GabiBrawl/Utsuwa/assets/Shopping Cart Screenshots/ALIEXPRESS.png

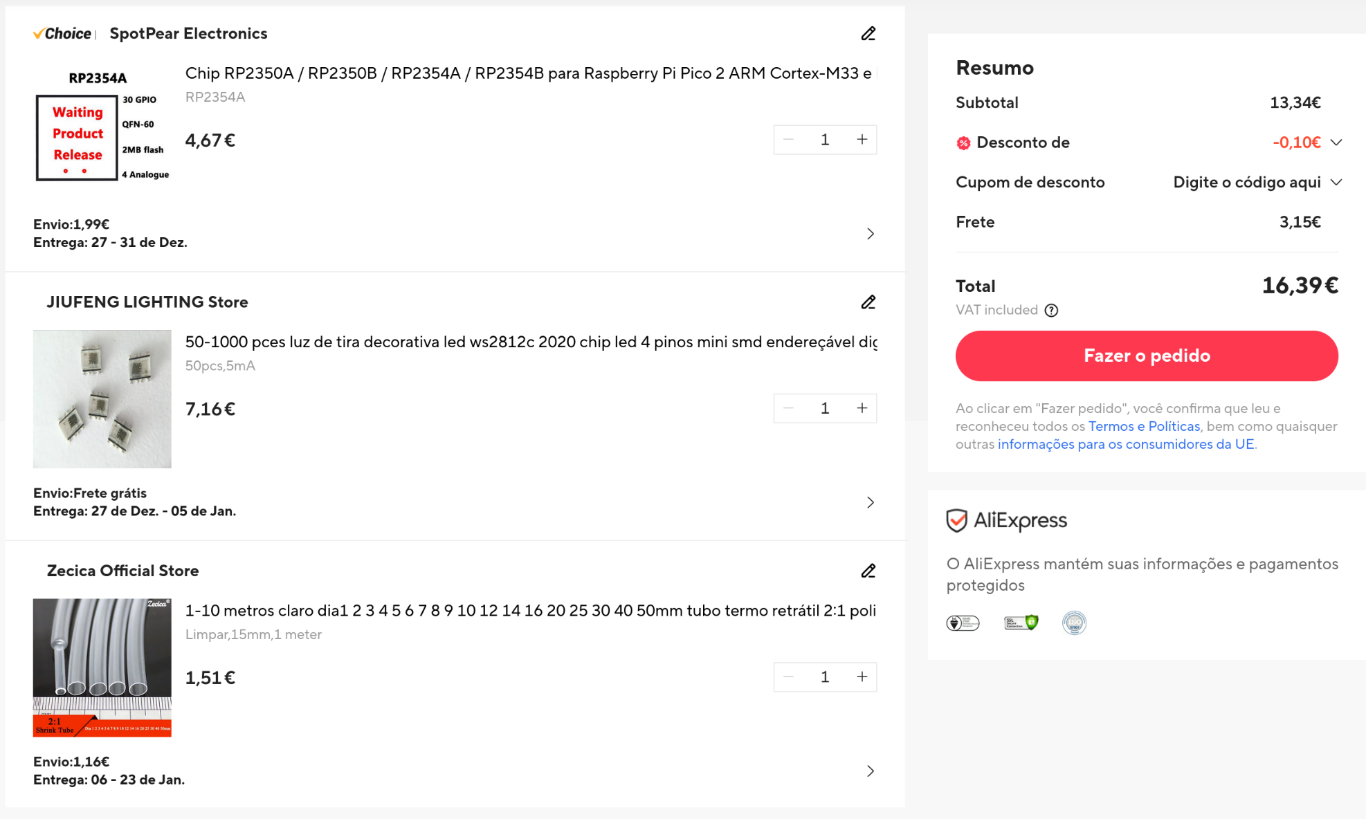
assets/Shopping Cart Screenshots/ALIEXPRESS.png
