GabiBrawl/Utsuwa/assets/Shopping Cart Screenshots/ALIEXPRESS_SHRINKING_TUBES.png

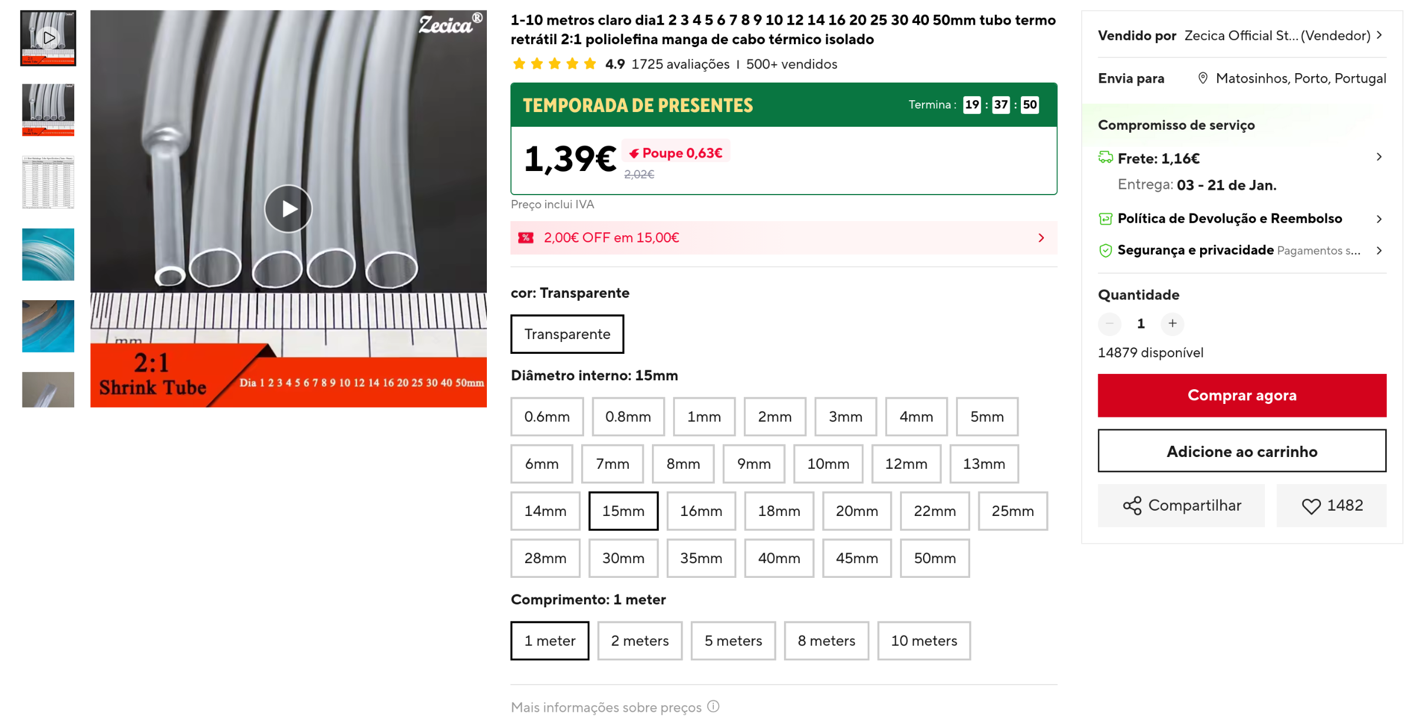
assets/Shopping Cart Screenshots/ALIEXPRESS_SHRINKING_TUBES.png
