GabiBrawl/Utsuwa/assets/Shopping Cart Screenshots/DIGIKEY1.png

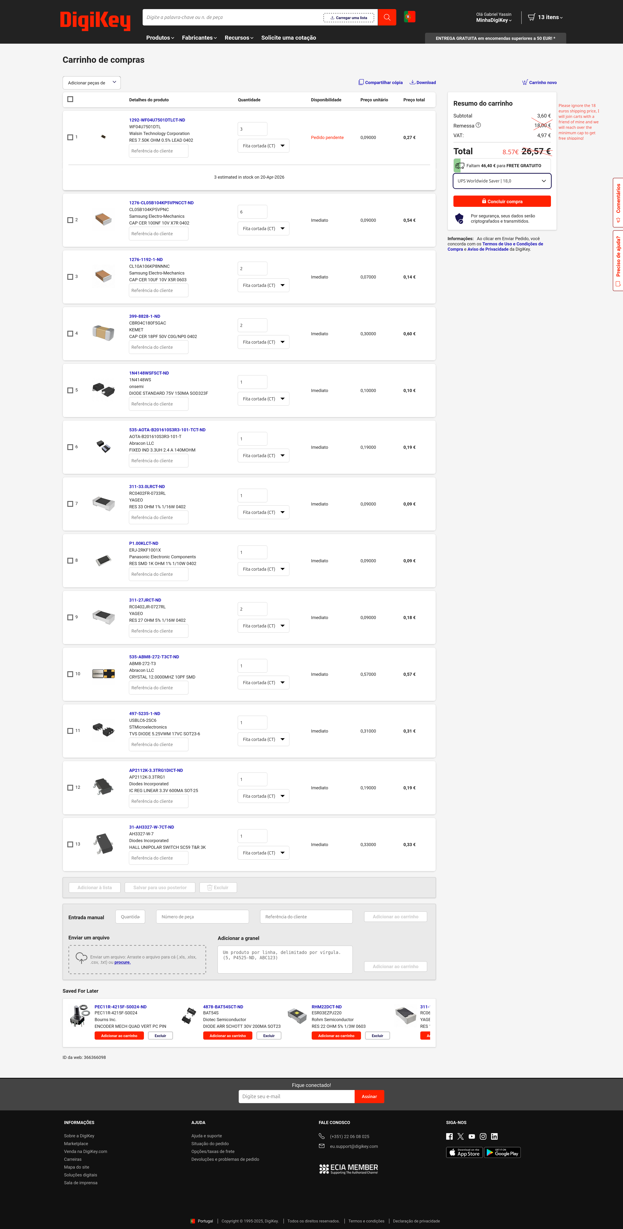
assets/Shopping Cart Screenshots/DIGIKEY1.png
