GabiBrawl/Utsuwa/assets/Shopping Cart Screenshots/JLCPCB.png

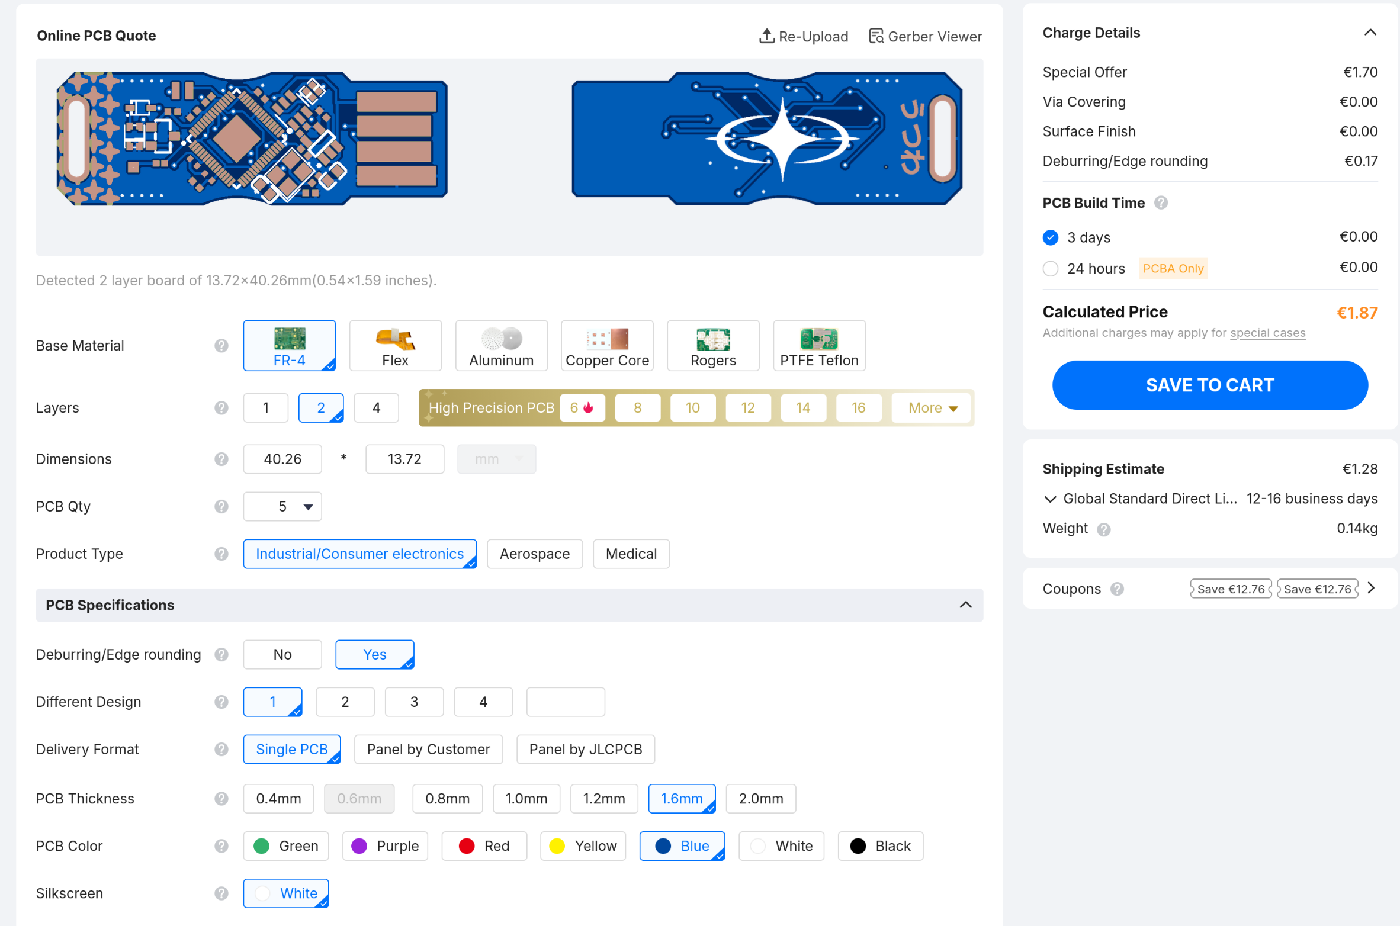
assets/Shopping Cart Screenshots/JLCPCB.png
