GabiBrawl/Utsuwa/assets/Shopping Cart Screenshots/MOUSER.png

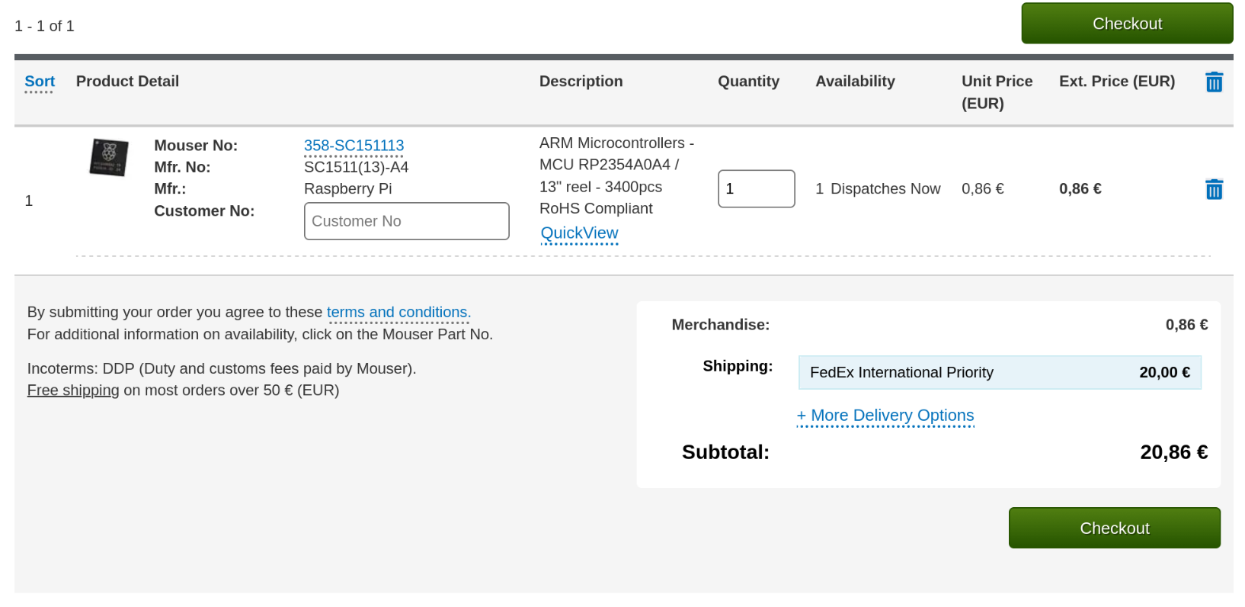
assets/Shopping Cart Screenshots/MOUSER.png
