GabiBrawl/Utsuwa/pcb/rev1/Utsuwa_schematics.pdf

# voltage stepdown

# MCU

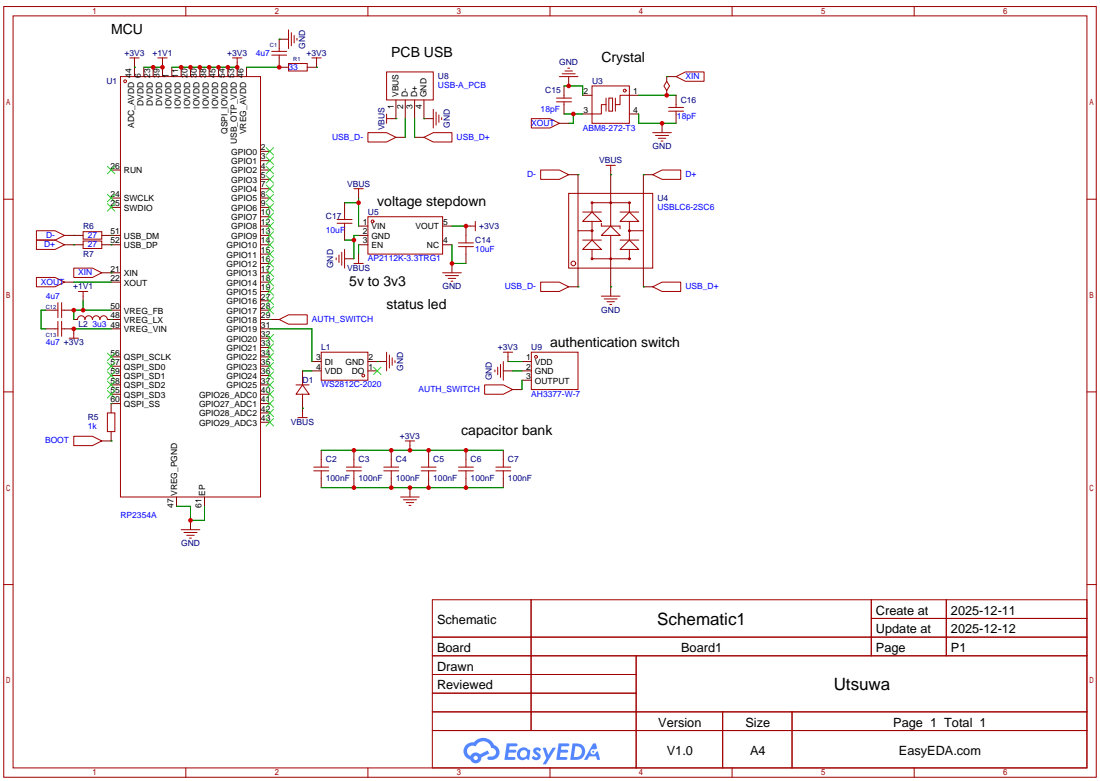
[picture p10: page 1]

Schematic | Schematic1 | Create at | 2025-12-11

Update at | 2025-12-12

Board | Board1 | Page | P1
Drawn | | Utsuwa
Reviewed

Version | Size | Page 1 Total 1
V1.0 | A4 | EasyEDA.com
