GabiBrawl/Utsuwa/(list of files, drawings)

Other design files:
pcb/rev1/Utsuwa_project.epro
