GabiBrawl/Utsuwa/(commit log)

2025-12-12 Added a screenshot of the schematics
    [bom.xlsx]
2025-12-12 Updated the bom to the correct extension and added most component prices.
    [bom.csv, bom.xlsx]
2025-12-13 Uploaded the gerber file. Uploaded the project hero image. Updated the README. Updated the BOM.
    [bom.csv]
2025-12-13 Added information about the predicted assembly method.
2025-12-14 Added the transparent shrinking tubes into the BOM
    [bom.csv]
2025-12-15 Updated the README and the BOM
    [bom.csv]
2025-12-17 Updated RP2354A pricing and supplier! Saved 5 bucks!!
    [bom.csv]
